RICHKUNG/Sand-Drawing-Robot/firmware/sand_table/endcode.h

float endcode[][2] = {
  { 57.501, 444.625 },
  { 64.729, 439.047 },
  { 72.566, 438.803 },
  { 78.900, 438.071 },
  { 87.482, 437.321 },
  { 90.065, 437.095 },
  { 132.576, 437.095 },
  { 139.018, 437.827 },
  { 144.600, 438.071 },
  { 150.612, 439.047 },
  { 153.188, 437.095 },
  { 153.940, 436.362 },
  { 154.476, 434.166 },
  { 155.986, 414.943 },
  { 156.624, 406.828 },
  { 157.268, 394.868 },
  { 157.482, 384.373 },
  { 157.268, 380.467 },
  { 156.624, 378.515 },
  { 154.906, 376.562 },
  { 153.188, 377.538 },
  { 152.329, 381.444 },
  { 150.182, 397.065 },
  { 149.109, 403.899 },
  { 147.606, 408.781 },
  { 144.493, 415.127 },
  { 141.165, 418.544 },
  { 133.435, 421.473 },
  { 105.094, 421.473 },
  { 103.054, 420.253 },
  { 100.371, 416.592 },
  { 98.116, 411.954 },
  { 97.365, 405.852 },
  { 97.365, 302.361 },
  { 97.687, 297.967 },
  { 98.653, 294.550 },
  { 101.229, 291.621 },
  { 122.700, 291.621 },
  { 127.853, 292.842 },
  { 131.288, 296.503 },
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
};
