RICHKUNG/Sand-Drawing-Robot/firmware/sand_table/gcode.h

float gcode[][2] = {
  { 276.000, 276.000 },
  { 46.000, 404.500 },
  { 92.903, 404.500 },
  { 95.640, 393.134 },
  { 98.377, 381.769 },
  { 101.114, 370.403 },
  { 103.851, 359.038 },
  { 106.588, 347.672 },
  { 109.325, 336.307 },
  { 112.061, 324.941 },
  { 114.798, 313.575 },
  { 117.535, 302.210 },
  { 120.272, 290.844 },
  { 123.009, 279.479 },
  { 124.255, 274.305 },
  { 124.255, 327.875 },
  { 119.362, 330.862 },
  { 116.480, 332.621 },
  { 116.480, 404.500 },
  { 155.607, 404.500 },
  { 155.607, 332.621 },
  { 147.832, 328.553 },
  { 147.832, 226.160 },
  { 152.757, 223.583 },
  { 155.607, 222.091 },
  { 155.607, 150.212 },
  { 108.704, 150.212 },
  { 103.046, 172.610 },
  { 100.216, 183.809 },
  { 97.387, 195.008 },
  { 94.557, 206.207 },
  { 91.728, 217.405 },
  { 88.899, 228.604 },
  { 86.069, 239.803 },
  { 83.240, 251.002 },
  { 80.410, 262.201 },
  { 77.581, 273.399 },
  { 77.352, 274.305 },
  { 77.352, 226.160 },
  { 85.128, 222.091 },
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
};
